GabrielDM703/Proyecto-Placas-PCB-Agricultura/Proteus/CaraArriba.pdf

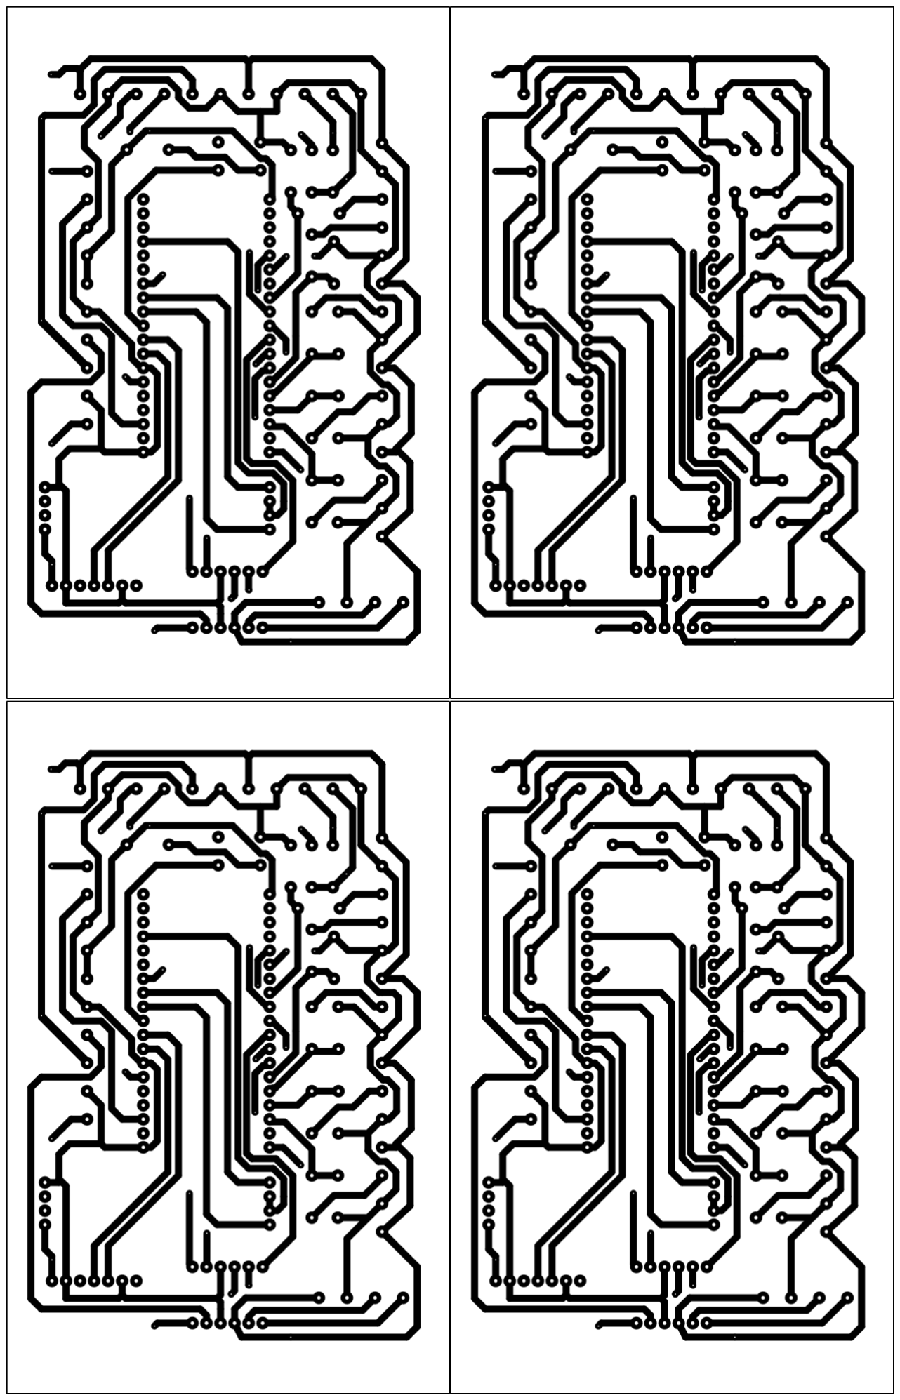
[picture p14: page 1]
