GabrielDM703/Proyecto-Placas-PCB-Agricultura/Proteus/CaraBajo.pdf

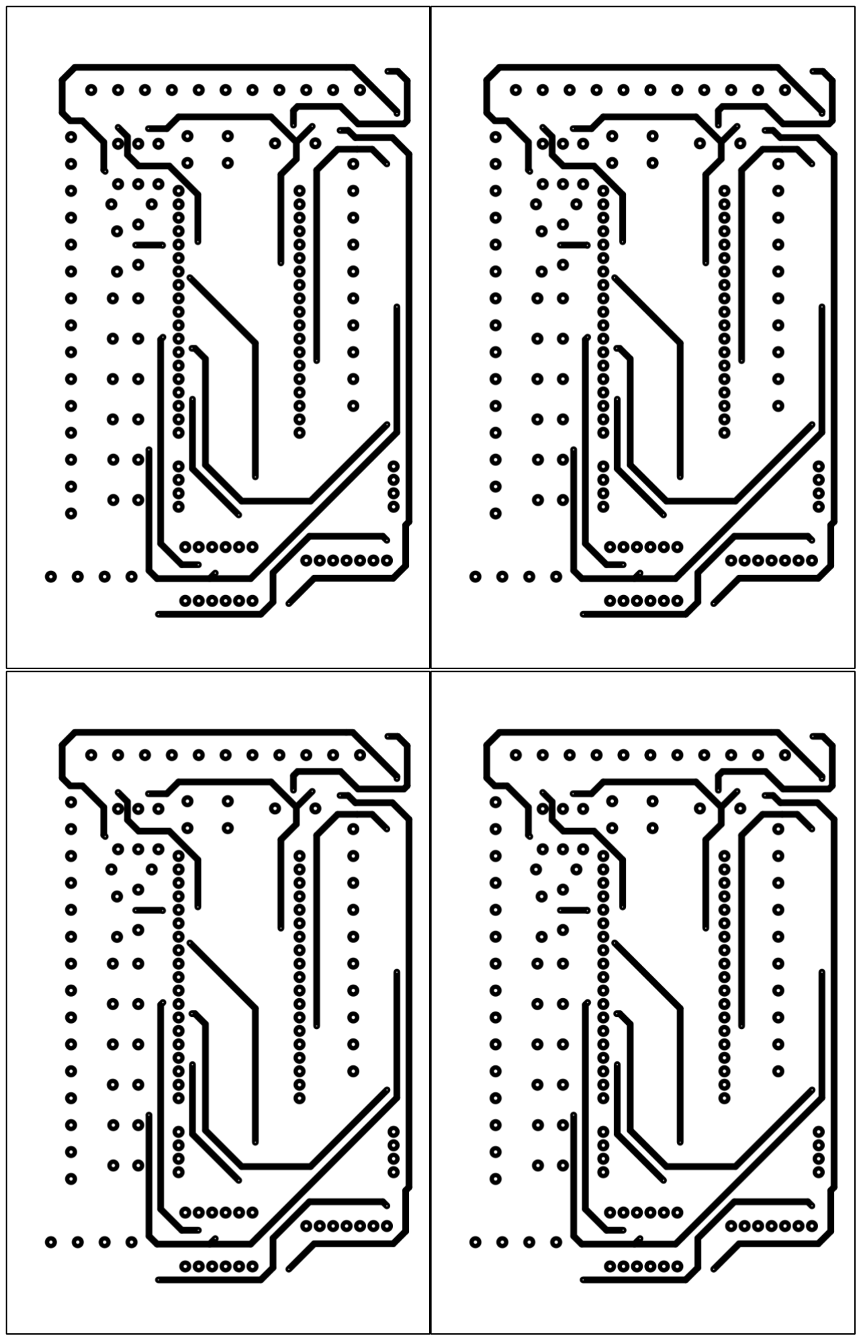
[picture p15: page 1]
