GabrielDM703/Proyecto-Placas-PCB-Agricultura/Proteus/Etiquetas.pdf

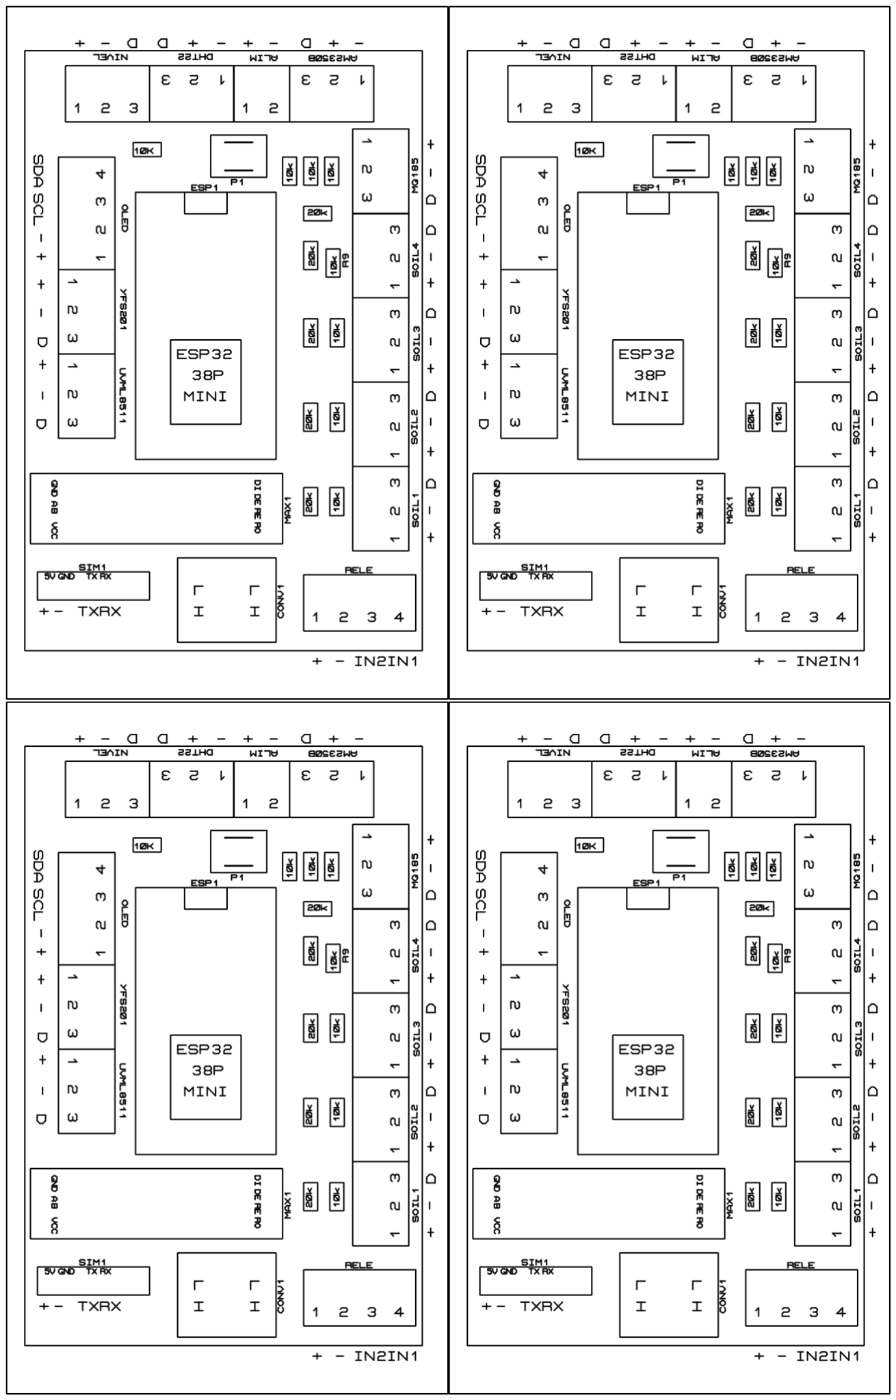
[picture p16: page 1]
