GabrielDM703/Proyecto-Placas-PCB-Agricultura/Imagenes/Placas_Perforadas.jpeg

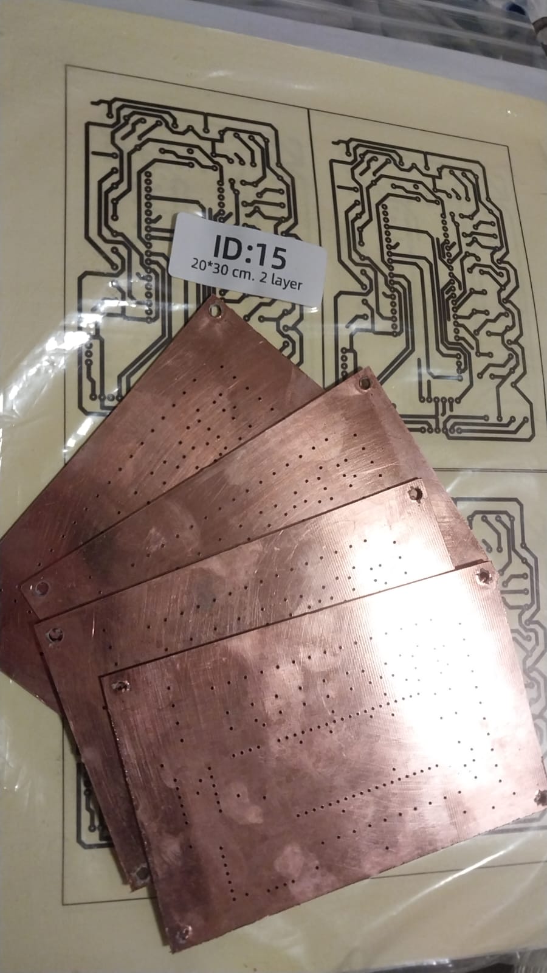
Imagenes/Placas_Perforadas.jpeg
