GabrielDM703/Proyecto-Placas-PCB-Agricultura/(list of files, drawings)

Other design files:
Proteus/Proyecto Agricultura.pdsprj
